vinmarshall/WWVB-Clock/wwvb_clock_schematic.png

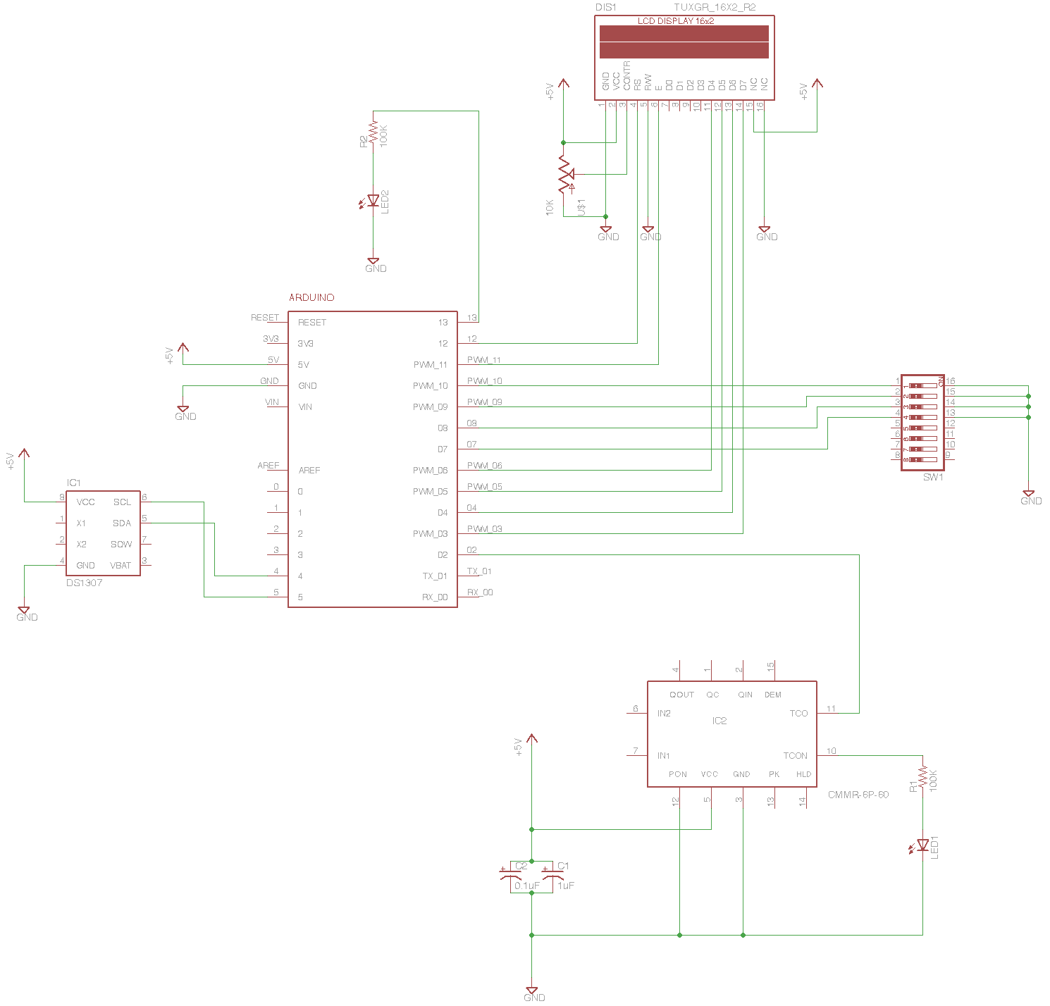
wwvb_clock_schematic.png
