vinmarshall/WWVB-Clock/(commit log)

2010-03-18 added schematic
2010-05-17 fixed missing } in buffer()
    [wwvb_clock.pde]
